rejunity/z80-open-silicon/docs/3x2_tiles.png

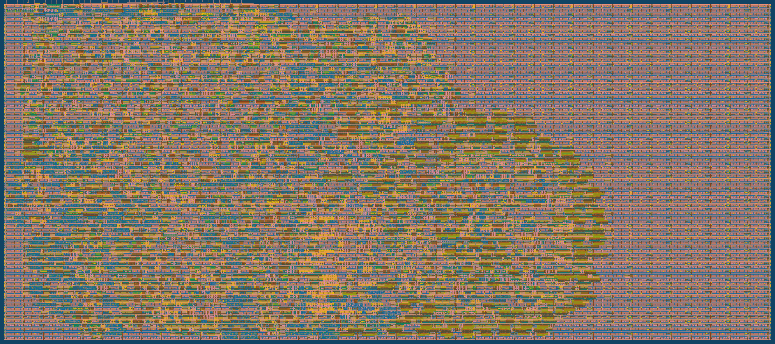
docs/3x2_tiles.png
