rejunity/z80-open-silicon/docs/4x2_tiles.png

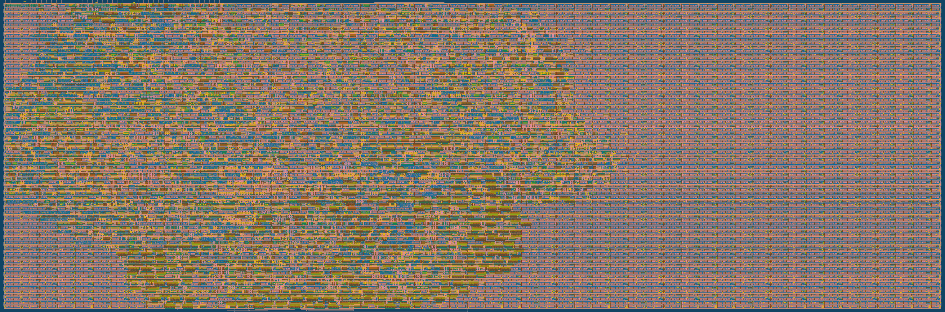
docs/4x2_tiles.png
