rejunity/z80-open-silicon/docs/github_cover.png

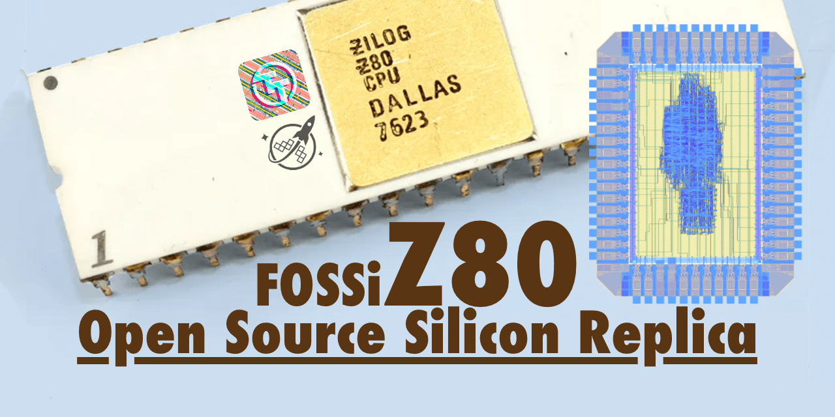
docs/github_cover.png
