rejunity/z80-open-silicon/docs/tt07_chip.png

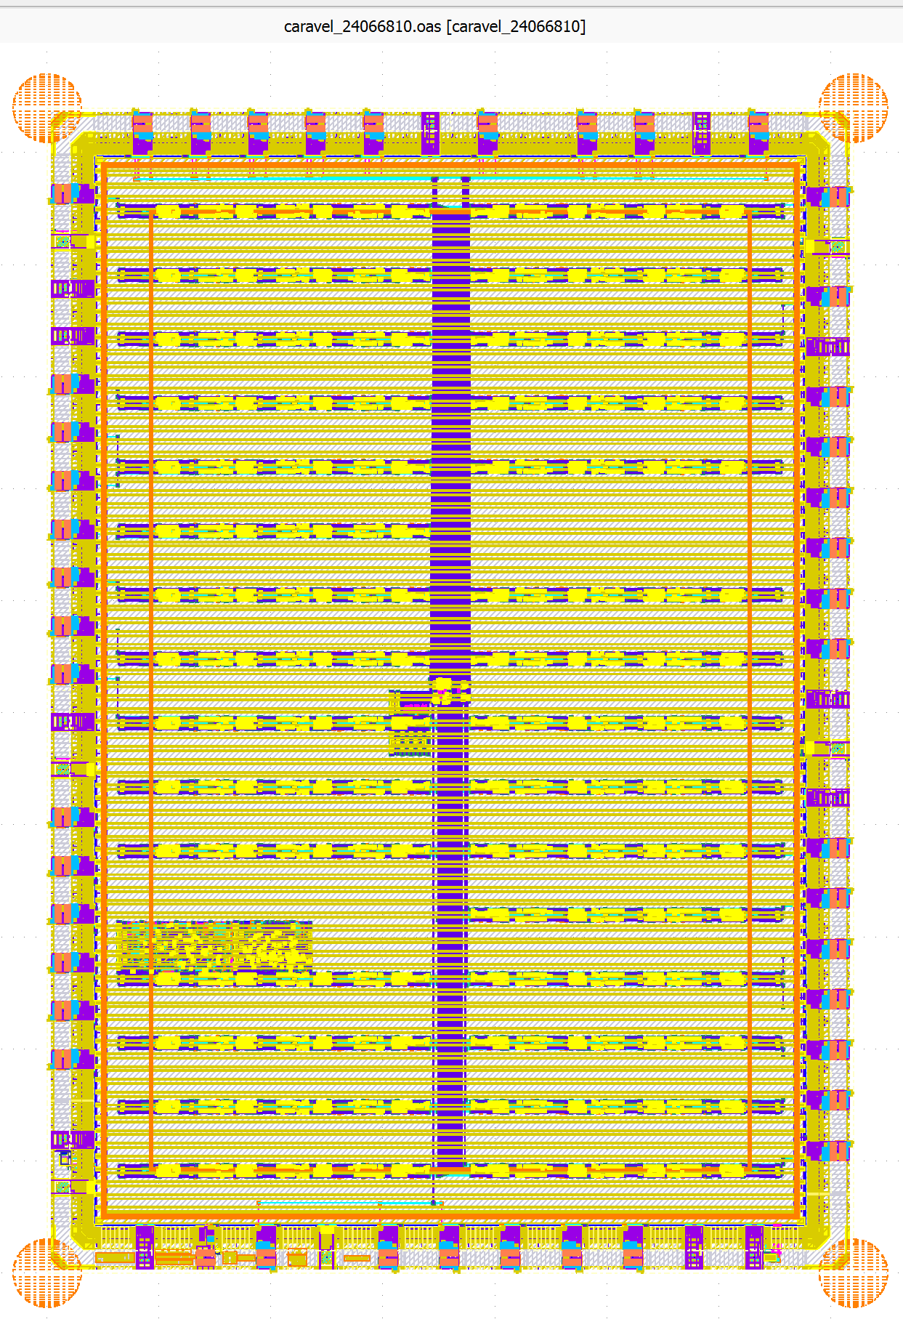
docs/tt07_chip.png
