rejunity/z80-open-silicon/docs/ws0_z80_wip.png

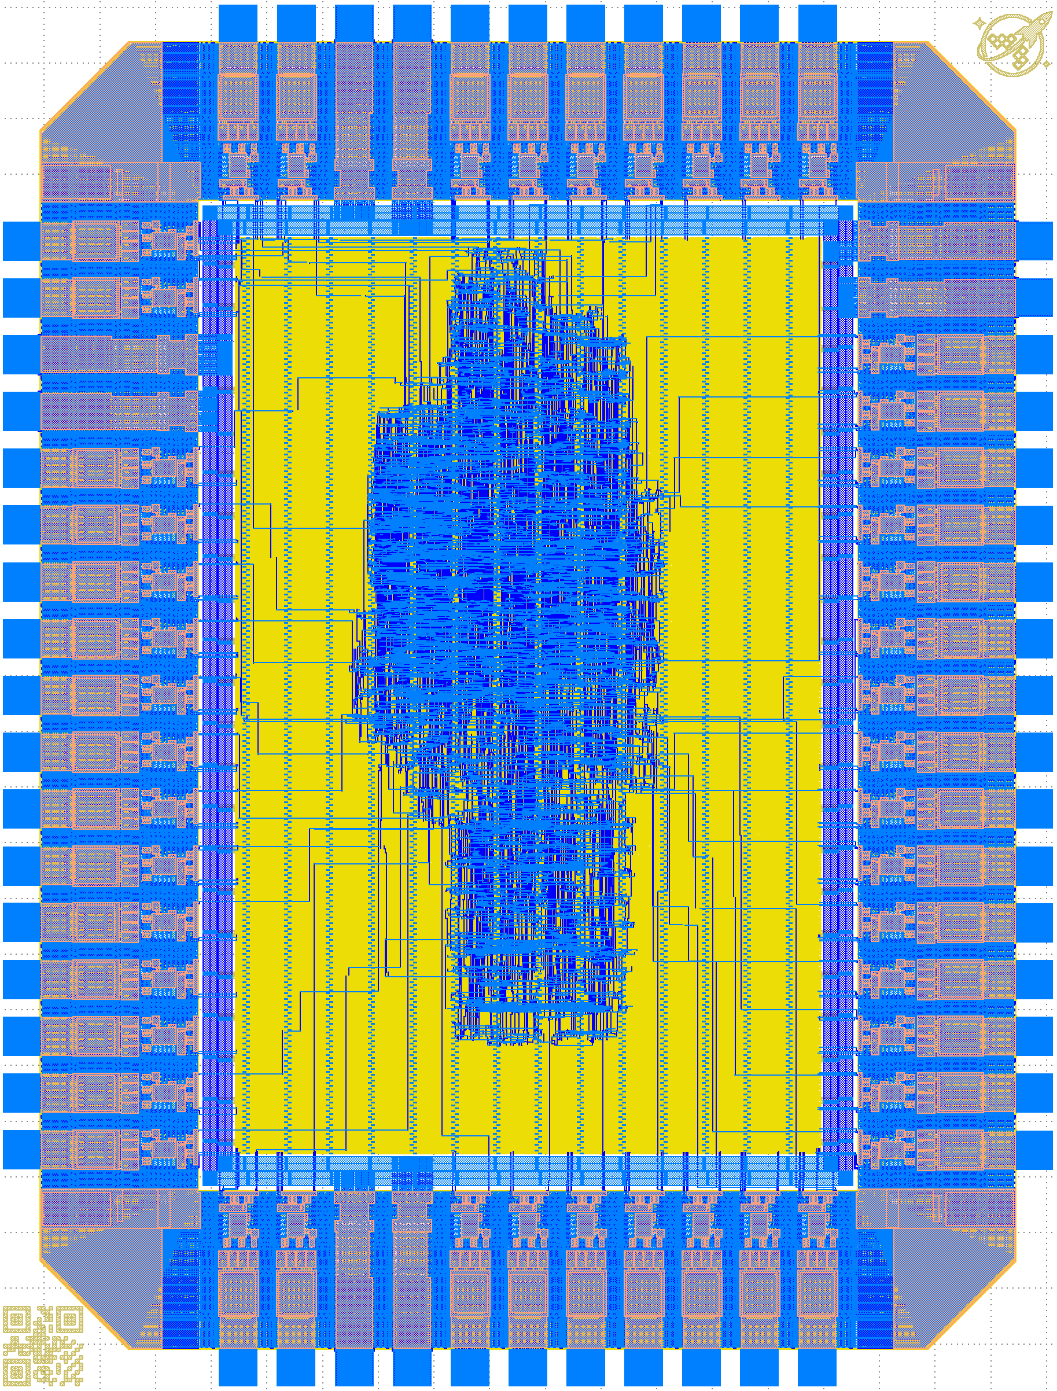
docs/ws0_z80_wip.png
