rejunity/z80-open-silicon/docs/z80-pinout-from-Zilog-Data-Book.png

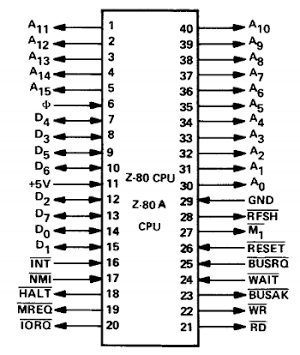
docs/z80-pinout-from-Zilog-Data-Book.png
