rejunity/z80-open-silicon/(threads)

Thread 1 (2024-05-02):

Family

omikron88, 2024-05-02:
Do you plan to "revive" some other members of Z80 family too, in the future? Such as CTC or PIO?
I can provide some testing of real samples on logic analyser.

How fast the new Z80 will be?

rejunity, 2024-05-02:
> CTC or PIO
No plans for CTC and PIO yet, mostly because I don't know 8-bit computers that ever used them. If you have a good example / case why they would be important - please let me know!

Instead, I was thinking about packaging Z80 with AY sound processor, Spectrum ULA and maybe TMS99xx, HD6845. Basically making small SoC (System on Chip) that could handle ZX Spectrum, Amstrad CPC and some MSX models. But that is a long term project.

> I can provide some testing of real samples on logic analyser.
That would be great! There are couple of people that volunteered for hardware testing already and I will be looking for several more! I will keep you posted.

> How fast the new Z80 will be?
According to simulation 50 MHz, but maybe 66 MHz.

omikron88, 2024-05-02:
> No plans for CTC and PIO yet, mostly because I don't know 8-bit computers that ever used them. If you have a good example / case why they would be important - please let me know!

They are, but not so frequently as CPU. Most used is CTC (and also simplest), then PIO. Sharp MZ for example. The rarest is DMA and DART.

>
> Instead, I was thinking about packaging Z80 with AY sound processor, Spectrum ULA and maybe TMS99xx, HD6845. Basically making small SoC (System on Chip) that could handle ZX Spectrum, Amstrad CPC and some MSX models. But that is a long term project.

This is a good idea. Spectrum ULA is becoming rare. But there is a little problem: Some pins are analog. Video output for example. But ULA is well documented at technology and gate level

rejunity, 2024-05-03:
> But there is a little problem: Some pins are analog.

This is not FPGA :) we can do analog pins!

Closed 2024-05-06.

Thread 2 (2024-05-04):

What about a breakout like this?

psychogenic, 2024-05-04:
Hi,

Playing around with this a bit, am thinking of doing something like this:

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

The idea is to be as transparent and true as possible, so I'm taking the input clock and multiplying it by 4 to do the multiplexing.

Initial floorplanning says I might, just might, be able to fit this on a 40 pin DIP that would slot right into place (assuming I get to populate the ASIC top side and the rest underneath).

Does this look like it would make sense to you?

psychogenic, 2024-05-04:
The MCU is there to setup the project through the TT MUX, and manage timing/latches and such, but would not interfere with anything.

rejunity, 2024-05-05:
This looks great! Thank you and fingers crossed it fits in DIP40 sized PCB!

NOTE, I just realised one issue with my MUX approach combined with ZX Spectrum and frequency multiplier. The clock that is passed to Z80 on ZX Spectrum can be abruptly varying!
In "normal" circumstances Z80 gets 3.5 MHz clock (derived from PAL frequency) HOWEVER in case of memory contention between the video (ULA) and CPU - ULA wins and temporarily pauses Z80 clock. I assume that would cause an issue with U8 multiplier, right?

For example see:
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

See pin 32 from ULA (IC1) feeding into pin 6 of Z80 (IC2).

So, I am thinking, maybe it is better to have 2 clock inputs in TT design - one clock to drive internal Z80 core and another (higher) to drive internal multiplexor? In case of ZX Spectrum higher clock could come directly from 14 MHz crystal oscillator instead of multiplier.

urish, 2024-05-05:
For project selection, you may want to go with something like the [PY32F002A](https://www.lcsc.com/product-detail/Microcontroller-Units-MCUs-MPUs-SOCs_PUYA-PY32F002AW15U6TR_C5291740.html) instead of the ATtiny?

Cheaper and the footprint is also smaller (QFN-16), if I'm not mistaken

psychogenic, 2024-05-05:
Hm, I'm not actually seeing where the 3.5MHz clock actually comes from, but the interrupted clock--with no extra signaling just an abrupt hold--does look problematic...  Will try and ponder.
As for the PY32F002A: it's small, and damn cheap.  The MCU selection was preliminary--just wanted something cheap that could use an internal clock and have enough flash on board to play, and I like the AVR 2 series stuff.  I also *really* like datasheets I can actually read.

rejunity, 2024-05-05:
> Hm, I'm not actually seeing where the 3.5MHz clock actually comes from

I added some annotation, ULA creates interrupted 3.5MHz signal for CPU based on 14MHz:

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

omikron88, 2024-08-05:
> > Hm, I'm not actually seeing where the 3.5MHz clock actually comes from
>
> I added some annotation, ZX Spectrum's ULA creates an interrupted 3.5MHz signal to drive Z80 based on 14MHz crystal:

ULA creates Z80 clock by dividing its master 14MHz oscillator. But it holds Z80s clock high (measured at Z80 pin) during the video memory contention.
Here is the link to book about ULA chip, which describes the circuit at gate level:

https://www.tomas-franke.cz/public/The-ZX-Spectrum-ULA.pdf

By the way, I wrote ULA core in Verilog, that is compliant with the book. We can put it on Tiny Tapeout one day.
But I do not know, how to define the analog functions pins for Tiny Tapeout. For example the video output pins.

Thread 3 (2024-05-05):

Compare A-Z80 core to current TV80

rejunity, 2024-05-05:
Replace TV80 with A-Z80 core https://github.com/gdevic/A-Z80

Compare:
- die area
- support for illegal instructions

omikron88, 2024-08-06:
A Z80 is based on die analysis of real Zilog Z80 CPU. I expect it will be more accurate, than re-implementation.
Other thing is die area.

Thread 5 (2024-05-06):

TODO: Implement testbench for precise timing of the signals / bus

rejunity, 2024-05-06:
Validate signal timing follows the Z80 [datasheet](http://www.z80.info/zip/z80.pdf):

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

Simplified:
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

Also check [Z80 Protocol Decoder](https://stardot.org.uk/forums/viewtopic.php?f=3&t=15464) bus recordings.

Thread 6 (2024-06-25):

List of (recent) DYI computer kits that use Z80 (Request for more test-case systems)

GaiusJocundus, 2024-06-25:
This is a bit of an odd request, perhaps, but I think you'll see it makes sense.

I'm sure it's no surprise that there is a modern collection of new Z80 computer designs available; famously started with the rc2014 and less famously with the LiNC80. These systems have been dramatically improved upon in the Small Computer Central line of computers by Stephen C. Cousins.

There are other designs as well, notably the Zeal-8-Bit computer, with its memory manager and brand new, from scratch OS written in assembly and compiled with the z88dk toolchain.

These newer designs, some of which are brand new and some of which represent extended variations of historic designs, are quite robust and are used heavily in low-level computer education.

Small Computer Central is particularly important for having adopted, documented, extended, and developed peripherals for both the RCBus and Z50Bus; streamlining development for the community and empowering a great deal of third-party hardware extension by community members.

I believe that it would be wise for the project to, at the very least, highlight the RC2014 as a targeted platform. This would include the bulk of the Small Computer Central (SCC) designs as they are largely compatible. Including explicit callouts to other designs like LiNC80 -- which is a progenitor of other designs that are more popular; largely from SCC -- or Zeal-8-Bit Computer specifically may also help. Zeal-8-Bit is largely a new design but it represents a standard somewhat on par with the Commander X16.

I'm just setting up this issue as a suggestion for consideration, please feel free to close or ignore it at your discretion; if it is not an appropriate request for the project. I use these systems as daily drivers for both self-taught, low level computing education and for published educational works. To me they represent a modern standard for both vintage computing and modern, 8-bit software and hardware development.

Much obliged!

rejunity, 2024-07-31:
Absolutely! @GaiusJocundus thank you for suggestion and pointers. I have updated README with the list and will keep an eye on those machines.

Once we have first chips I would be looking for beta testers who could try FOSS Z80 with recent DYI Z80 kits!

Please don't hesitate to contribute with more interesting machines for testing!

tynemouthsoftware, 2024-07-31:
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

I designed the Minstrel 2, 3 and 4th kits that are based on the ZX80, ZX81 and Jupiter Ace respectively. All are Z80 based through hole self assembly kits. Now limited by the Z80 EOL, so would be interested to test out Z80 replacements in those.

Thanks,

Dave

GaiusJocundus, 2024-08-01:
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

Thank you so much! I'm very glad my suggestion proves helpful. I would love to be among the beta testers and have many devices to test with. I'll be able to test multiple operating systems, monitors, peripherals, and build toolchains and applications.

I very appreciate the work you're doing here, the Z80 should belong to the people at this point, anyway. EOL may have been the best thing for the community with teams like this picking up the project.

Much obliged!

Closed 2024-08-01.
