rejunity/z80-open-silicon/(commit log)

2024-04-21 TV80 sources (missing file)
    [tv80s.v]
2024-04-26 More die shots including rare ones
2024-05-07 ZX Spectrum 128K timing & schematics link
2025-06-09 exposed EARLY_SIGNALS control over MREQ, IORQ, RD signals to ui_in[5:4] pins
    // [00] --- MREQ, IORQ, RD are short - 1 cycle
    // [01] --- MREQ, IORQ, RD start 0.5 cycle earlier
    // [10] --- MREQ, IORQ are 1.5 cycle long and start earlier
    // RD is 1 cycle, but starts half cycle earlier
    // [11] --- MREQ, IORQ, RD are 1.5 cycle long
    // and start 0.5 cycles earlier
    [tt_um_rejunity_z80.v]
2025-06-09 short (1 cycle) RD never starts early, updated tests with 0b11 for control signals (early and long)
    [test.py, tt_um_rejunity_z80.v]
2025-06-09 added early signals control (called CONFIG) pin description to info.yaml
2025-06-09 small info.yaml pin doc update
2025-10-03 For Valdemar (zxx-pcb)
2025-12-15 WIP image of chip for Wafer.Space GF180MCU run 1 shuttle in the 5mm^2 configuration.
